cmccaskey/THUNKIT-ALTIMETERS/LWRA/HARDWARE/LWRA REV M/LWRA_SCHEM.png

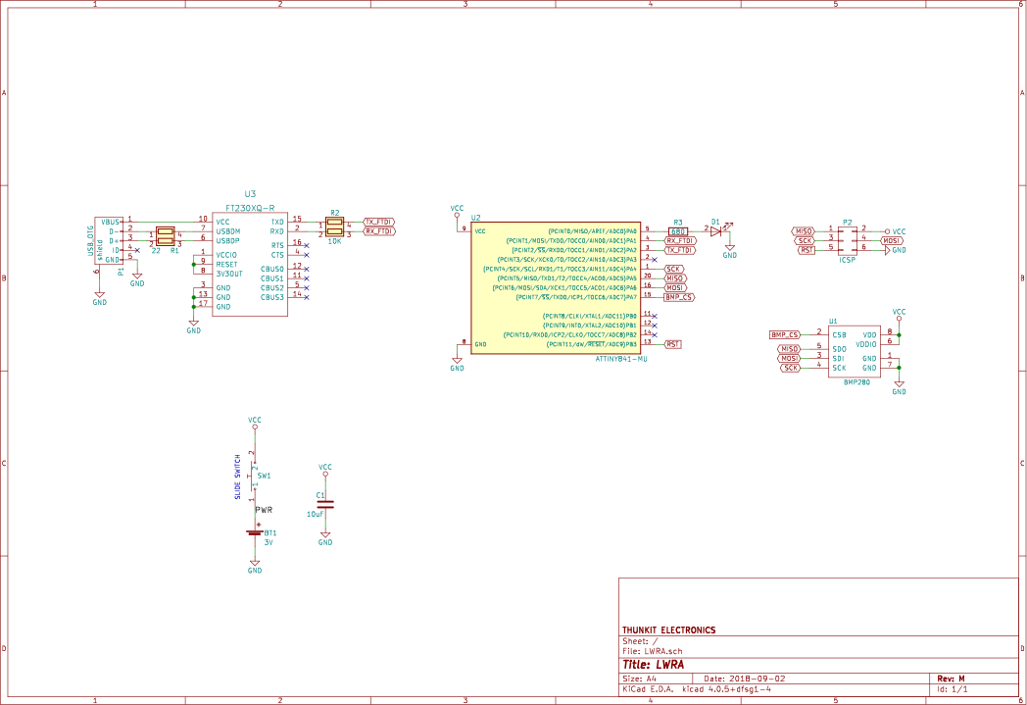
LWRA/HARDWARE/LWRA REV M/LWRA_SCHEM.png
