cmccaskey/THUNKIT-ALTIMETERS/SOFTWARE/LAUNCH DATA/OCT_6_2018/OCT_6_2018_L1.png

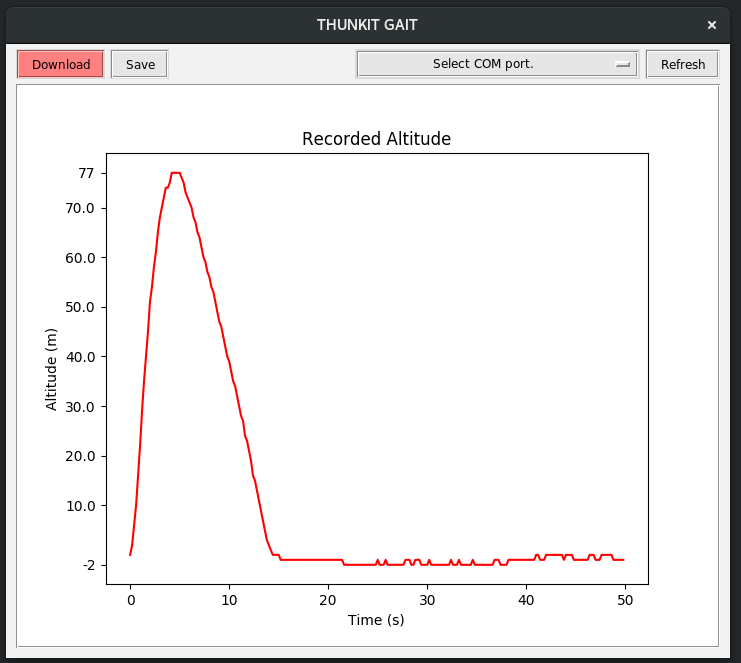
SOFTWARE/LAUNCH DATA/OCT_6_2018/OCT_6_2018_L1.png
