cmccaskey/THUNKIT-ALTIMETERS/LWRA/HARDWARE/LWRA REV M/LWRA_BOM.ods

Designator | Package | Designation | Supplier and Ref.
BT1 | BK-870 | 3V | Digi-Key# BK-870-ND
C1 | C_0805 | 10uF | Arrow# CC0805KRX5R6BB106
D1 | LED_0603 | LED | Arrow# LTST-C193KRKT-5A
P1 | USB_Micro-B_Molex_47346-0001 | USB_OTG | Digi-Key# 609-4613-1-ND
R1 | R_Array_Convex_2x0603 | 22 | Digi-Key# ‎RHM1381CT-ND‎
R2 | R_Array_Convex_2x0603 | 10K | Digi-Key# ‎RHM1589CT-ND‎
R3 | R_0603 | 680 | Digi-Key# A130090TR-ND
SW1 | JS102011JAQN_Handsoldering | Push_SW (Slide) | Digi-Key# CKN10720CT-ND
U1 | LGA-8_NO_DOT | BMP280 | Arrow# BMP280
U2 | QFN-20-1EP_4x4mm_Pitch0.5mm_NO_PIN_10 | ATTINY841-MU | Digi-Key# ATTINY841-MU-ND
U3 | QFN-16_4x4mm_Pitch0.65mm_NO_PIN_12 | FT230XQ-R | Digi-Key# 768-1130-1-ND
