cmccaskey/THUNKIT-ALTIMETERS/DDPLY/HARDWARE/DDPLY REV C/DDPLY.pdf

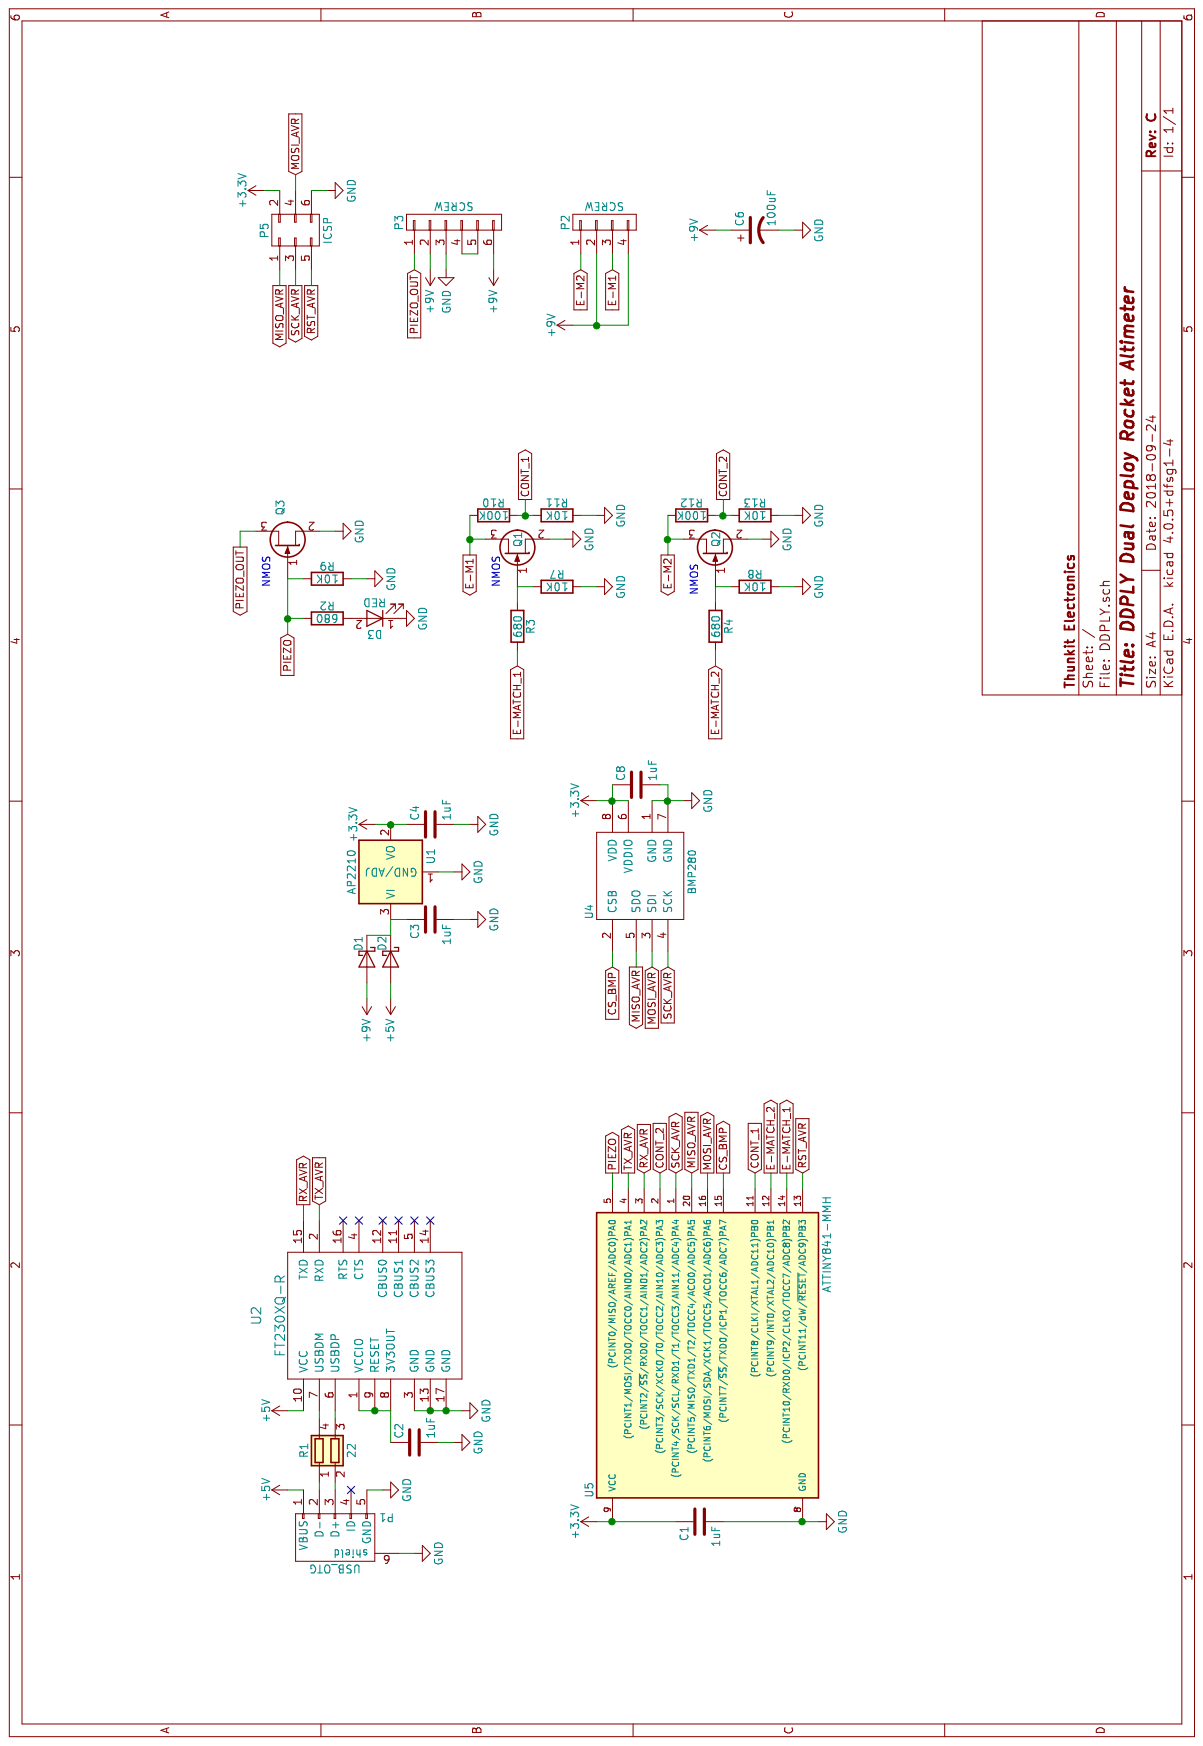
[picture p5: page 1]
