cmccaskey/THUNKIT-ALTIMETERS/LWRA/HARDWARE/LWRA REV M/LWRA_SCHEM.pdf

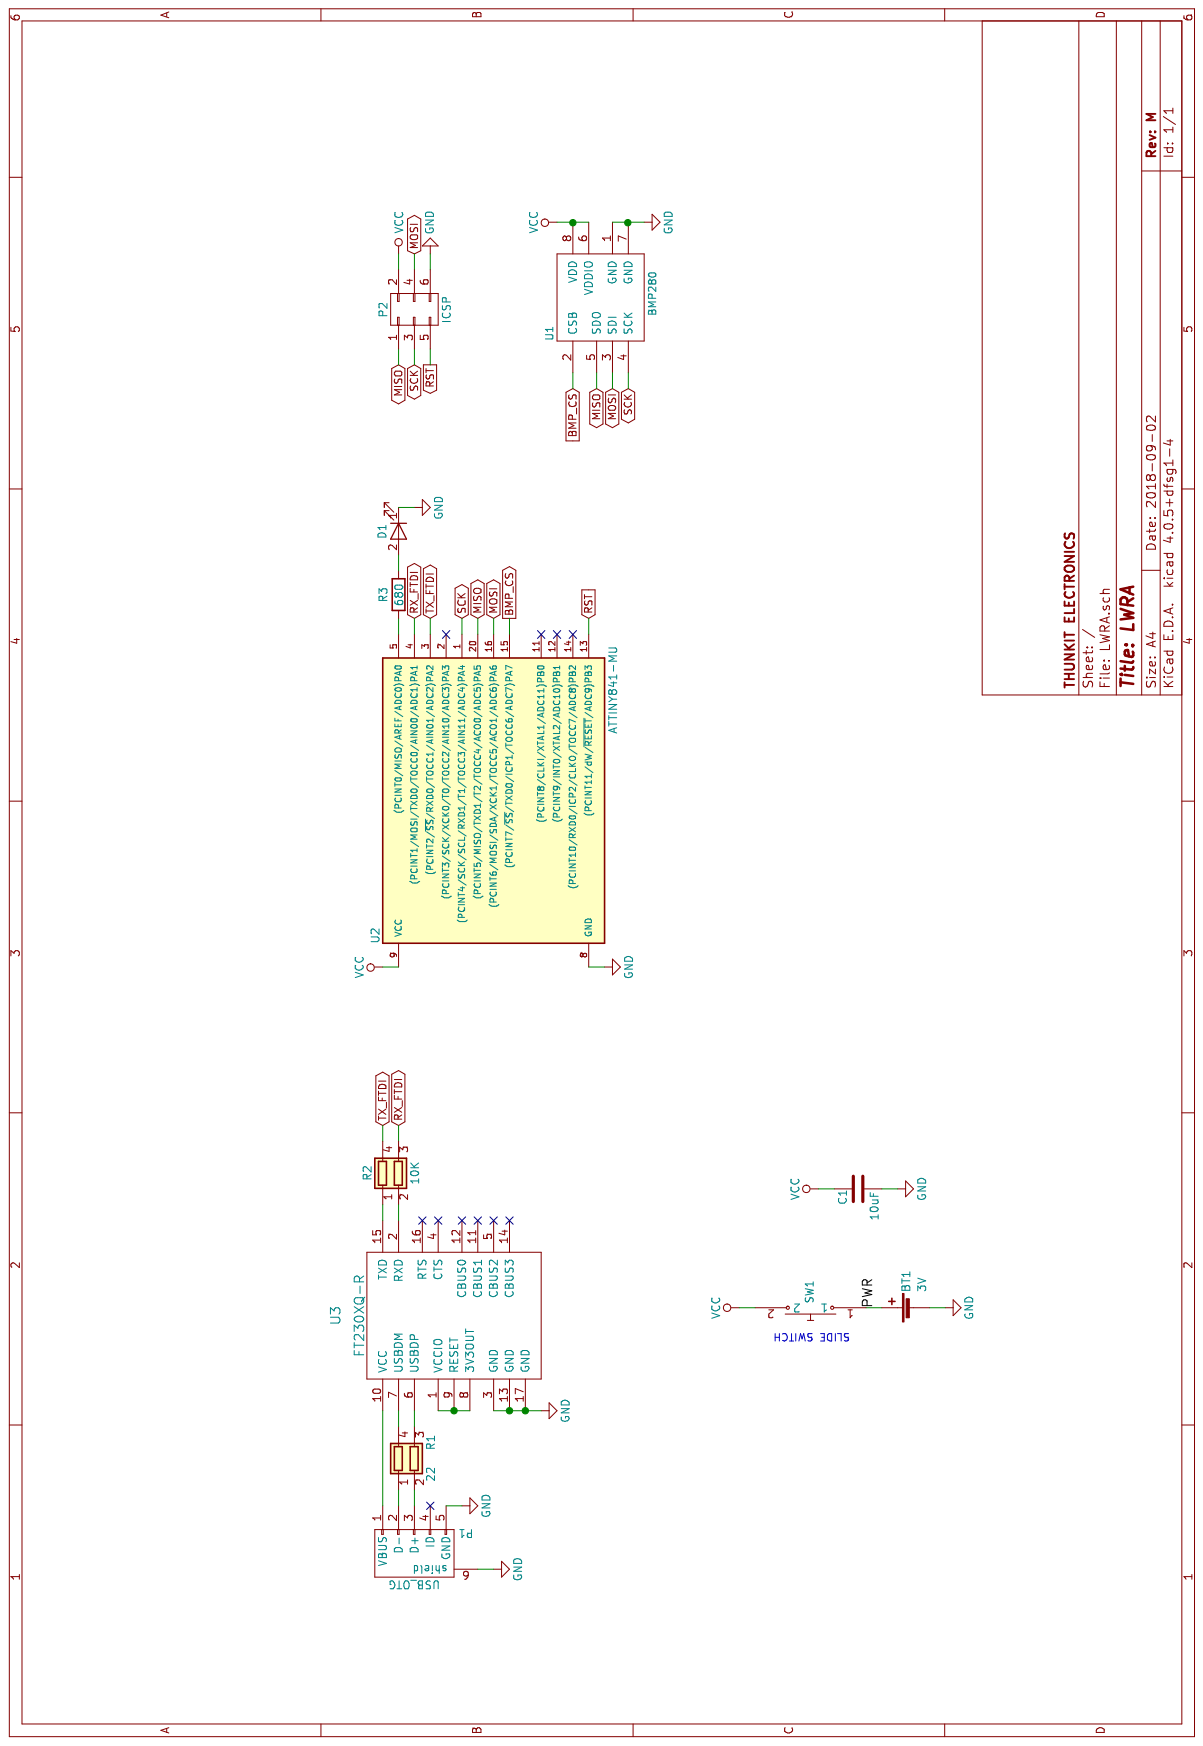
[picture p6: page 1]
