cmccaskey/THUNKIT-ALTIMETERS/DDPLY/HARDWARE/DDPLY REV C/DDPLY.kicad_pcb

## KiCad design DDPLY/HARDWARE/DDPLY REV C/DDPLY.kicad_pcb (2018-09-24)

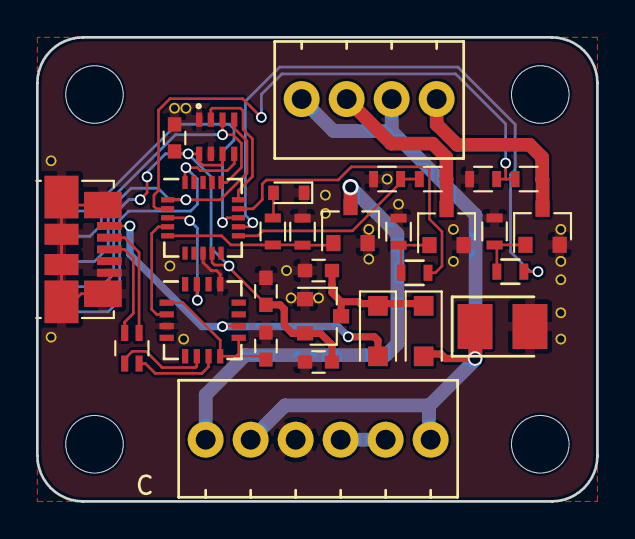
[picture p7: board DDPLY.kicad_pcb from above]

Board: 2 copper layers, 31.1 x 25.8 mm, 31 parts (1 on the bottom side), 29 nets.

Parts:
C1, C2, C3, C4, C8: 1uF; C_0603
C6: 100uF; Tantalum_Case-B_EIA-3528-21_Reflow
D1, D2: D_Schottky; D_SOD-123F
D3: RED; D_0603
P1: USB_OTG; USB_Micro-B_Molex_47346-0001
P2: SCREW; 100MIL_STX4
P3: SCREW; 100MIL_STX6
P5: ICSP; LINEAR_ICSP
Q1, Q2, Q3: Q_NJFET_GSD; SOT-23
R1: 22; R_Array_Concave_2x0603
R2, R3, R4: 680; R_0603
R7, R8, R9, R11, R13: 10K; R_0603
R10, R12: 100K; R_0603
U1: AP2210; SOT-23
U2: FT230XQ-R; QFN-16_4x4mm_Pitch0.65mm
U4: BMP280; LGA-8_PIN1_DOT
U5: ATTINY841-MMH; QFN-20-1EP_4x4mm_Pitch0.5mm

Connections:
+3V3: C1.1, C4.1, C8.1, P5.2, U1.2, U4.6, U4.8, U5.9
+5V: D2.2, P1.1, U2.10
+9V: C6.1, D1.2, P2.2, P2.4, P3.2, P3.6
CONT_1: R10.2, R11.1, U5.11
CONT_2: R12.2, R13.1, U5.2
CS_BMP: U4.2, U5.15
E-M1: P2.3, Q1.3, R10.1
E-M2: P2.1, Q2.3, R12.1
E-MATCH_1: R3.2, U5.14
E-MATCH_2: R4.2, U5.12
GND: C1.2, C2.2, C3.2, C4.2, C6.2, C8.2, D3.1, P1.5, P1.6, P3.3, P5.6, Q1.2, Q2.2, Q3.2, R7.2, R8.2, R9.2, R11.2, R13.2, U1.1, U2.3, U2.13, U4.1, U4.7, U5.8
MISO_AVR: P5.1, U4.5, U5.20
MOSI_AVR: P5.4, U4.3, U5.16
unnamed: C2.1, U2.1, U2.8, U2.9
unnamed: C3.1, D1.1, D2.1, U1.3
unnamed: D3.2, R2.2
unnamed: P1.2, R1.1
unnamed: P1.3, R1.2
unnamed: P3.4, P3.5
unnamed: Q1.1, R3.1, R7.1
unnamed: Q2.1, R4.1, R8.1
unnamed: R1.3, U2.6
unnamed: R1.4, U2.7
PIEZO: Q3.1, R2.1, R9.1, U5.5
PIEZO_OUT: P3.1, Q3.3
RST_AVR: P5.5, U5.13
RX_AVR: U2.15, U5.3
SCK_AVR: P5.3, U4.4, U5.1
TX_AVR: U2.2, U5.4
