cmccaskey/THUNKIT-ALTIMETERS/LWRA/HARDWARE/LWRA REV M/SINGLE/LWRA.kicad_pcb

## KiCad design LWRA/HARDWARE/LWRA REV M/SINGLE/LWRA.kicad_pcb (2018-09-09)

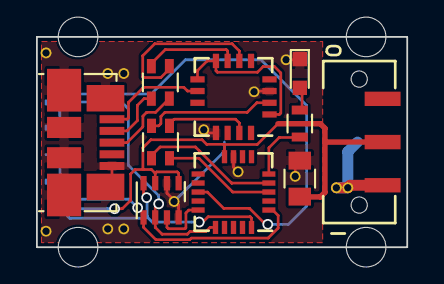
[picture p8: board LWRA.kicad_pcb from above]

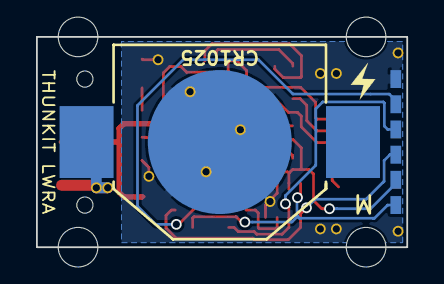
[picture p9: board LWRA.kicad_pcb from below]

Board: 2 copper layers, 20.6 x 11.7 mm, 12 parts (2 on the bottom side), 20 nets.

Parts:
BT1: 3V; BK-870
C1: 1uF; C_0805
D1: LED; LED_0603
P1: USB_OTG; USB_Micro-B_Molex_47346-0001
P2: ICSP; LINEAR_ICSP
R1: 22; R_Array_Convex_2x0603
R2: 1K; R_Array_Convex_2x0603
R3: 330; R_0603
SW1: Push_SW; JS102011JAQN_Handsoldering
U1: BMP280; LGA-8_NO_DOT
U2: ATTINY841-MU; QFN-20-1EP_4x4mm_Pitch0.5mm_NO_PIN_10
U3: FT230XQ-R; QFN-16_4x4mm_Pitch0.65mm_NO_PIN_12

Connections:
/PWR: BT1.1, SW1.1
BMP_CS: U1.2, U2.15
GND: BT1.2, C1.2, D1.1, P1.5, P1.6, P2.6, U1.1, U1.7, U2.8, U3.3, U3.13
MISO: P2.1, U1.5, U2.20
MOSI: P2.4, U1.3, U2.16
unnamed: D1.2, R3.1
unnamed: P1.1, U3.10
unnamed: P1.2, R1.1
unnamed: P1.3, R1.2
unnamed: R1.3, U3.6
unnamed: R1.4, U3.7
unnamed: R2.1, U3.15
unnamed: R2.2, U3.2
unnamed: R3.2, U2.5
unnamed: U3.1, U3.8, U3.9
RST: P2.5, U2.13
RX_FTDI: R2.3, U2.4
SCK: P2.3, U1.4, U2.1
TX_FTDI: R2.4, U2.3
VCC: C1.1, P2.2, SW1.2, U1.6, U1.8, U2.9
