cmccaskey/THUNKIT-ALTIMETERS/(commit log)

2018-09-09 file recovery and updates
    [Castellated ICSP.kicad_pcb, ICSP.kicad_pcb, ICSP.sch, LWRA.kicad_pcb, LWRA.sch, LWRA_BOM.ods, POGO ICSP.kicad_pcb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]
2018-09-11 fixed pin 1 dot on LWRA, firmware folder renamed
    [DDPLY.sch, LWRA.kicad_pcb]
2018-09-12 LWRA BOM fix
    [DDPLY.kicad_pcb, DDPLY.sch, LWRA_BOM.ods]
2018-09-24 added gate resistors DDPLY
    [DDPLY.csv, DDPLY.kicad_pcb, DDPLY.sch]
2018-09-25 fuses script for LWRA
2018-09-25 Fuses script for DDPLY
2018-10-07 huge updates
    [OCT_6_2018_L1.csv, OCT_6_2018_L1.ods]
2018-10-10 linux binary
    [OCT_6_2018_L1.csv, OCT_6_2018_L1.ods]
